wagiminator/ATtiny814-NRF2USB/hardware/NRF2USB_BOM.tsv

ID | Name | Designator | Footprint | Quantity | Manufacturer Part | Manufacturer | Supplier | Supplier Part
1 | 100n | C1,C4 | 0603 | 2 | CC0603KRX7R9BB104 | YAGEO | LCSC | C14663
2 | 10u | C2 | 0603 | 1 | CL10A106MA8NRNC | SAMSUNG | LCSC | C96446
3 | 47u | C3 | 1206 | 1 | 1206F476M160NT | FH | LCSC | C30300
4 | 1u | C5,C6 | 0603 | 2 | CL10A105KB8NNNC | SAMSUNG | LCSC | C15849
5 | PWR | LED1 | LED_0603 | 1 | 19-217/GHC-YR1S2/3T | EVERLIGHT | LCSC | C72043
6 | PA7 | LED2 | LED_0603 | 1 | KT-0603R | KENTO | LCSC | C2286
7 | 1k | R1,R2,R3 | 0603 | 3 | 0603WAF1001T5E | UNI-ROYAL(厚声) | LCSC | C21190
8 | K3-2380S-E1 | SW1 | SW-SMD_K3-2380S-E1 | 1 | K3-2380S-E1 | Rectangular Connectors - Contacts | LCSC | C145837
9 | ATTINY814-SSN | U1 | SOIC-14_150MIL | 1 | ATTINY814-SSNR | Microchip Tech | LCSC | C182202
10 | CH340N | U2 | SOP-8_150MIL | 1 | CH340N | WCH(南京沁恒) | LCSC | C2977777
11 | AP2112K-3.3TRG1 | U3 | SOT-25-5 | 1 | AP2112K-3.3TRG1 | DIODES | LCSC | C51118
12 | NRF24L01 | U4 | NRF24L01+SMD | 1 | mininrf24l01 | Greatwall | aliexpress | ?
13 | USB-Plug | USB | USB-M-48 | 1 | USB-05 | SOFNG | LCSC | C112454
