wagiminator/ATtiny814-NRF2USB/hardware/NRF2USB_schematic.pdf

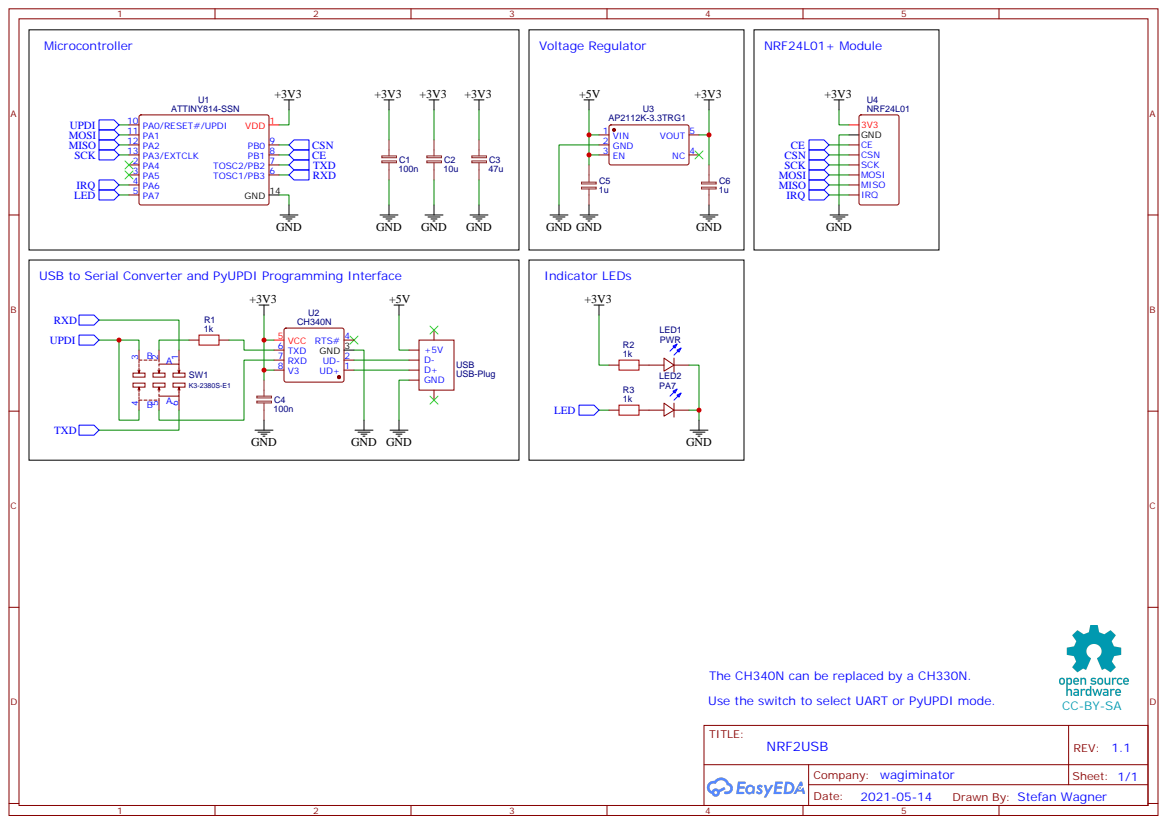
[picture p4: page 1]

USB to Serial Converter and PyUPDI Programming Interface

The CH340N can be replaced by a CH330N.
Use the switch to select UART or PyUPDI mode.

Drawn By: Stefan Wagner
